KidechaRahul/Function_Gen/Function_Gen.pdf

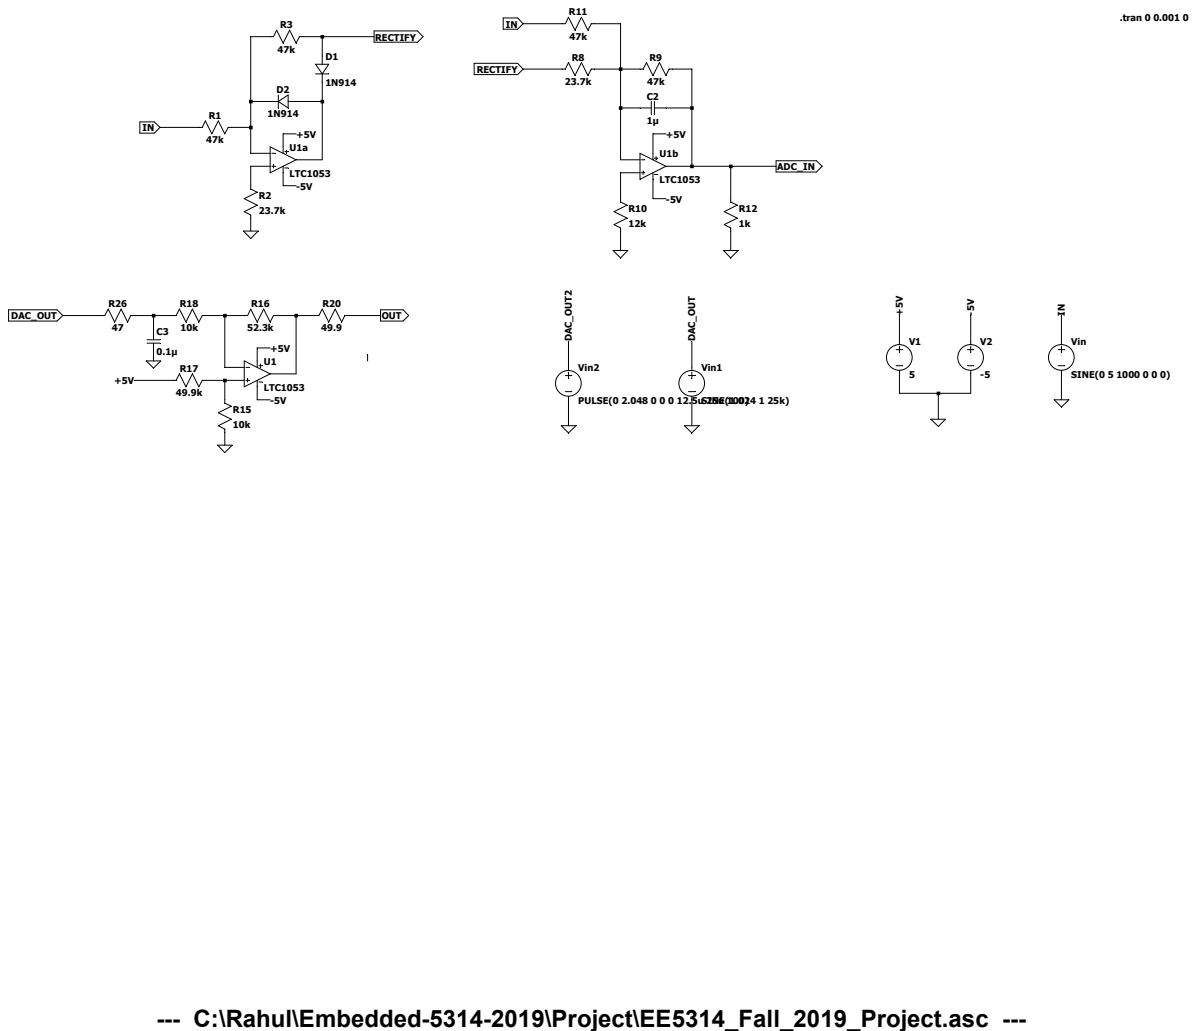
[picture p1: page 1]

--- C:\Rahul\Embedded-5314-2019\Project\EE5314_Fall_2019_Project.asc ---
