KidechaRahul/Function_Gen/Function_Gen.asc

C2: cap; 1µ
C3: cap; 0.1µ
D1: diode; 1N914
D2: diode; 1N914
R1: res; 47k
R2: res; 23.7k
R3: res; 47k
R8: res; 23.7k
R9: res; 47k
R10: res; 12k
R11: res; 47k
R12: res; 1k
R15: res; 10k
R16: res; 52.3k
R17: res; 49.9k
R18: res; 10k
R20: res; 49.9
R26: res; 47
U1: LTC1053
U1a: LTC1053
U1b: LTC1053
V1: voltage; 5
V2: voltage; -5
Vin1: voltage; SINE(1.024 1 25k); AC 0 0
Vin2: voltage; PULSE(0 2.048 0 0 0 12.5u 25u 100); AC 0 0
Vin: voltage; SINE(0 5 1000 0 0 0); AC 0 0
Named nets: IN, 0, +5V, -5V, ADC_IN, RECTIFY, OUT, DAC_OUT, DAC_OUT2
.tran 0 0.001 0
